RomainMarcazzan/cnc-setup/firmware/ReadMe.txt

Flash adresses
--------------

ESP32:

bootloader.bin 0x1000
partitions.bin 0x8000
firmware.bin   0x10000

ESP32-S3:

bootloader.bin 0x0
partitions.bin 0x8000
firmware.bin   0x10000
