RomainMarcazzan/cnc-setup/(commit log)

2026-04-20 update liste BOM
2026-04-20 docs: Simplifie et enrichit la documentation CNC
    - Réduit AGENTS.md de 987 à ~350 lignes (-65%)
    - Supprime sections redondantes (CNCjs, UGS, screen obsolète)
    - Ajoute section détaillée sur le G-code clamp_wood_v4.nc
    - Ajoute tableau comparatif vis Z simple vs multifilets
    - Copie le fichier G-code dans le dossier projet
    - Met à jour les réglages GRBL pour vis lead 8mm (=400)
2026-04-23 update BOM: cornières fer, partage 50/50 Philippe, mise en page PDF
2026-05-08 firmware: remplace MKS par grblHAL, ajoute binaires dans firmware/
    - Supprime références au firmware MKS LAS V1.0.10 (non supporté dual Y)
    - Ajoute dossier firmware/ avec les .bin grblHAL (build 20260506)
    - Met à jour FIRMWARE.md : chemin flasher, supprime section MKS archivée
    - Nettoie .gitignore des entrées MKS obsolètes
2026-05-11 📝 Mise à jour documentation + ajout snapshot EEPROM
    - Nouveau fichier EEPROM.md : snapshot config GRBL lu depuis la carte (2026-05-11)
    - AGENTS.md : Mise à jour firmware grblHAL, Dual Y (Y=Y1, A=Y2), états réels
    - FIRMWARE.md : Correction incohérence GT2 → HTD 3M, calcul steps/mm 71.11
    - CABLING.md : Connecteur A = Y2 (firmware Y-ganged), tableau câblage corrigé
2026-05-11 ⚙️ Config GRBL appliquée + snapshot EEPROM v2
    - $100-$102: 71.11 / 71.11 / 400 steps/mm
    - $110-$112: 3000 / 3000 / 1000 mm/min
    - $120-$122: 100 / 100 / 50 mm/sec²
    - $130-$132: 1200 / 1200 / 80 mm
2026-05-11 📋 Mise à jour checklist projet par phases
    - Nouvelle checklist complète organisée en 5 phases
    - Phase 1 = Tests électriques (SANS endstops)
    - Phase 2 = Montage mécanique
    - Phase 3 = Calibration mécanique
    - Phase 4 = Endstops & Homing
    - Phase 5 = Premier usinage
    - Mise à jour résumé final
2026-05-11 ✅ Phase 1 tests électriques complétés
    - Tous les moteurs testés : X, Y1, Y2, Z
    - Dual Y confirmé : Y1 antihoraire, Y2 horaire (sens opposés = normal)
    - Température TB6600 OK (tièdes, ventilateurs fonctionnent)
    - Mise à jour checklist Phase 1 → complétée
2026-05-11 🛡️ Ajout version G-code sécurisée pour tests sans endstops
    Fichier clamp_wood_v4_safe.nc :
    - Commente G28 (nécessite endstops)
    - Commente M0/M3/M5 (pause/broche inutiles sans broche)
    - Permet test 'air cut' avec moteurs à vide
    - Compatible test immédiat sans modification mécanique
2026-05-11 📝 Ajout section G-code sécurisé dans AGENTS.md
    - Mention du fichier clamp_wood_v4_safe.nc pour tests sans endstops
    - Instructions de test 'air cut' avec moteurs à vide
    - Avertissement sur les moteurs sans charge
